silvanalopezcuellar/ADC/README.md

# ADC
Implementación de un ADC con display 7 segmentos
Se expone la concepción y diseño de un ADC (Analog to digital converter) de 16 bits cuya entrada es adaptada para mostrar el valor RMS de la misma, y cuyo resultado se muestra en un siete segmentos de 4 dígitos, implementado por medio de un micro-controlador. Con el fin de ser posteriormente utilizado para relevar la señal de la línea en dado caso de una caída en el voltaje a la salida de la misma.
